owochel/light/_weekly/2023-02-22-time-lapse.markdown

---
layout: post
title: four hour time lapse of an interior space that’s part of my routine
date: 2023-02-22  12:56:58 -0500
---

<iframe width="640" height="640"
  src="https://user-images.githubusercontent.com/51350490/220714587-75f441b0-4b5c-4239-8f12-ee7faa338c1c.mp4">
</iframe>

This is the time lapse shoot on go pro this morning from 6-ish to whenever the battery died. The light changed from a dim white to brighter warm yellow around second 11 in the video. The shadow of the handle is really sharp on the shades, and you can start to see the toothed edge of the bricks on the exterior wall as the shadow moves to the left. Around second 33, the shadow disappeared and reappeared after a few seconds which I assume is caused by a cloud.
