owochel/light/_posts/2023-02-08-candle.markdown

---
label: assignments
layout: post
title: "candle"
date: 2023-02-08 16:32:58 -0500
categories: jekyll update
---

This project asks us to uses an arduino and [NeoPixel jewel](https://www.adafruit.com/product/2226) to create a candle.
I chose to use a Nano 33 BLE and a photocell to accomplish a torch that "borrows" light.

The borrowing parts were straightforward enough. I am able to program the turning on process pretty fast.
I spend some time trying to think of ways I can turn the torch off because the photocell won't be able to read a difference in light changes when the NeoPixel is on.
As Ijon suggested, there are lots of sensors in BLE that could come in handy. I ended up using the accelerometer in the BLE to program a state-change.

The code can be found [here]({{ site.codeurl}}\_candle/candle/candle.ino ).

The limitation of this project is that it requires some tuning in every environment. The changes in environmental lights and/or lending light sources requires a different threshold value in the code.

See the video below for demo:

<iframe width="640" height="360"
  src="https://user-images.githubusercontent.com/51350490/220449124-2332311c-d367-40be-866d-badaaa0c6117.mp4">
</iframe>
