owochel/light/_weeklyPhoto/construction.jpg

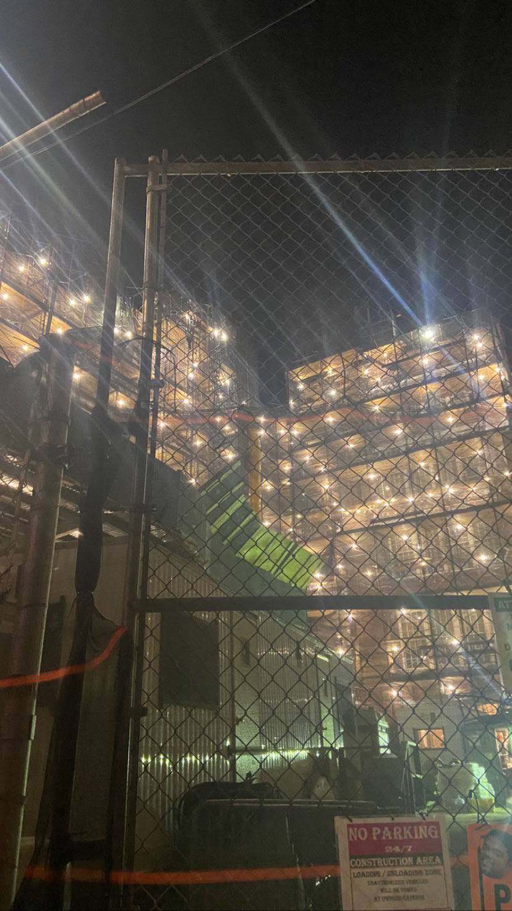
_weeklyPhoto/construction.jpg
