owochel/light/(commit log)

2023-02-01 Assignment 1
    Use PWM on microcontrollers to fade LEDs
2023-02-01 Circuit Photo
2023-02-21 images for 12v
2023-02-21 12v redo
